hsetlik/DirtyMirrorV2/DirtyMirrorV2.kicad_pcb

## KiCad design DirtyMirrorV2.kicad_pcb (2026-08-28)

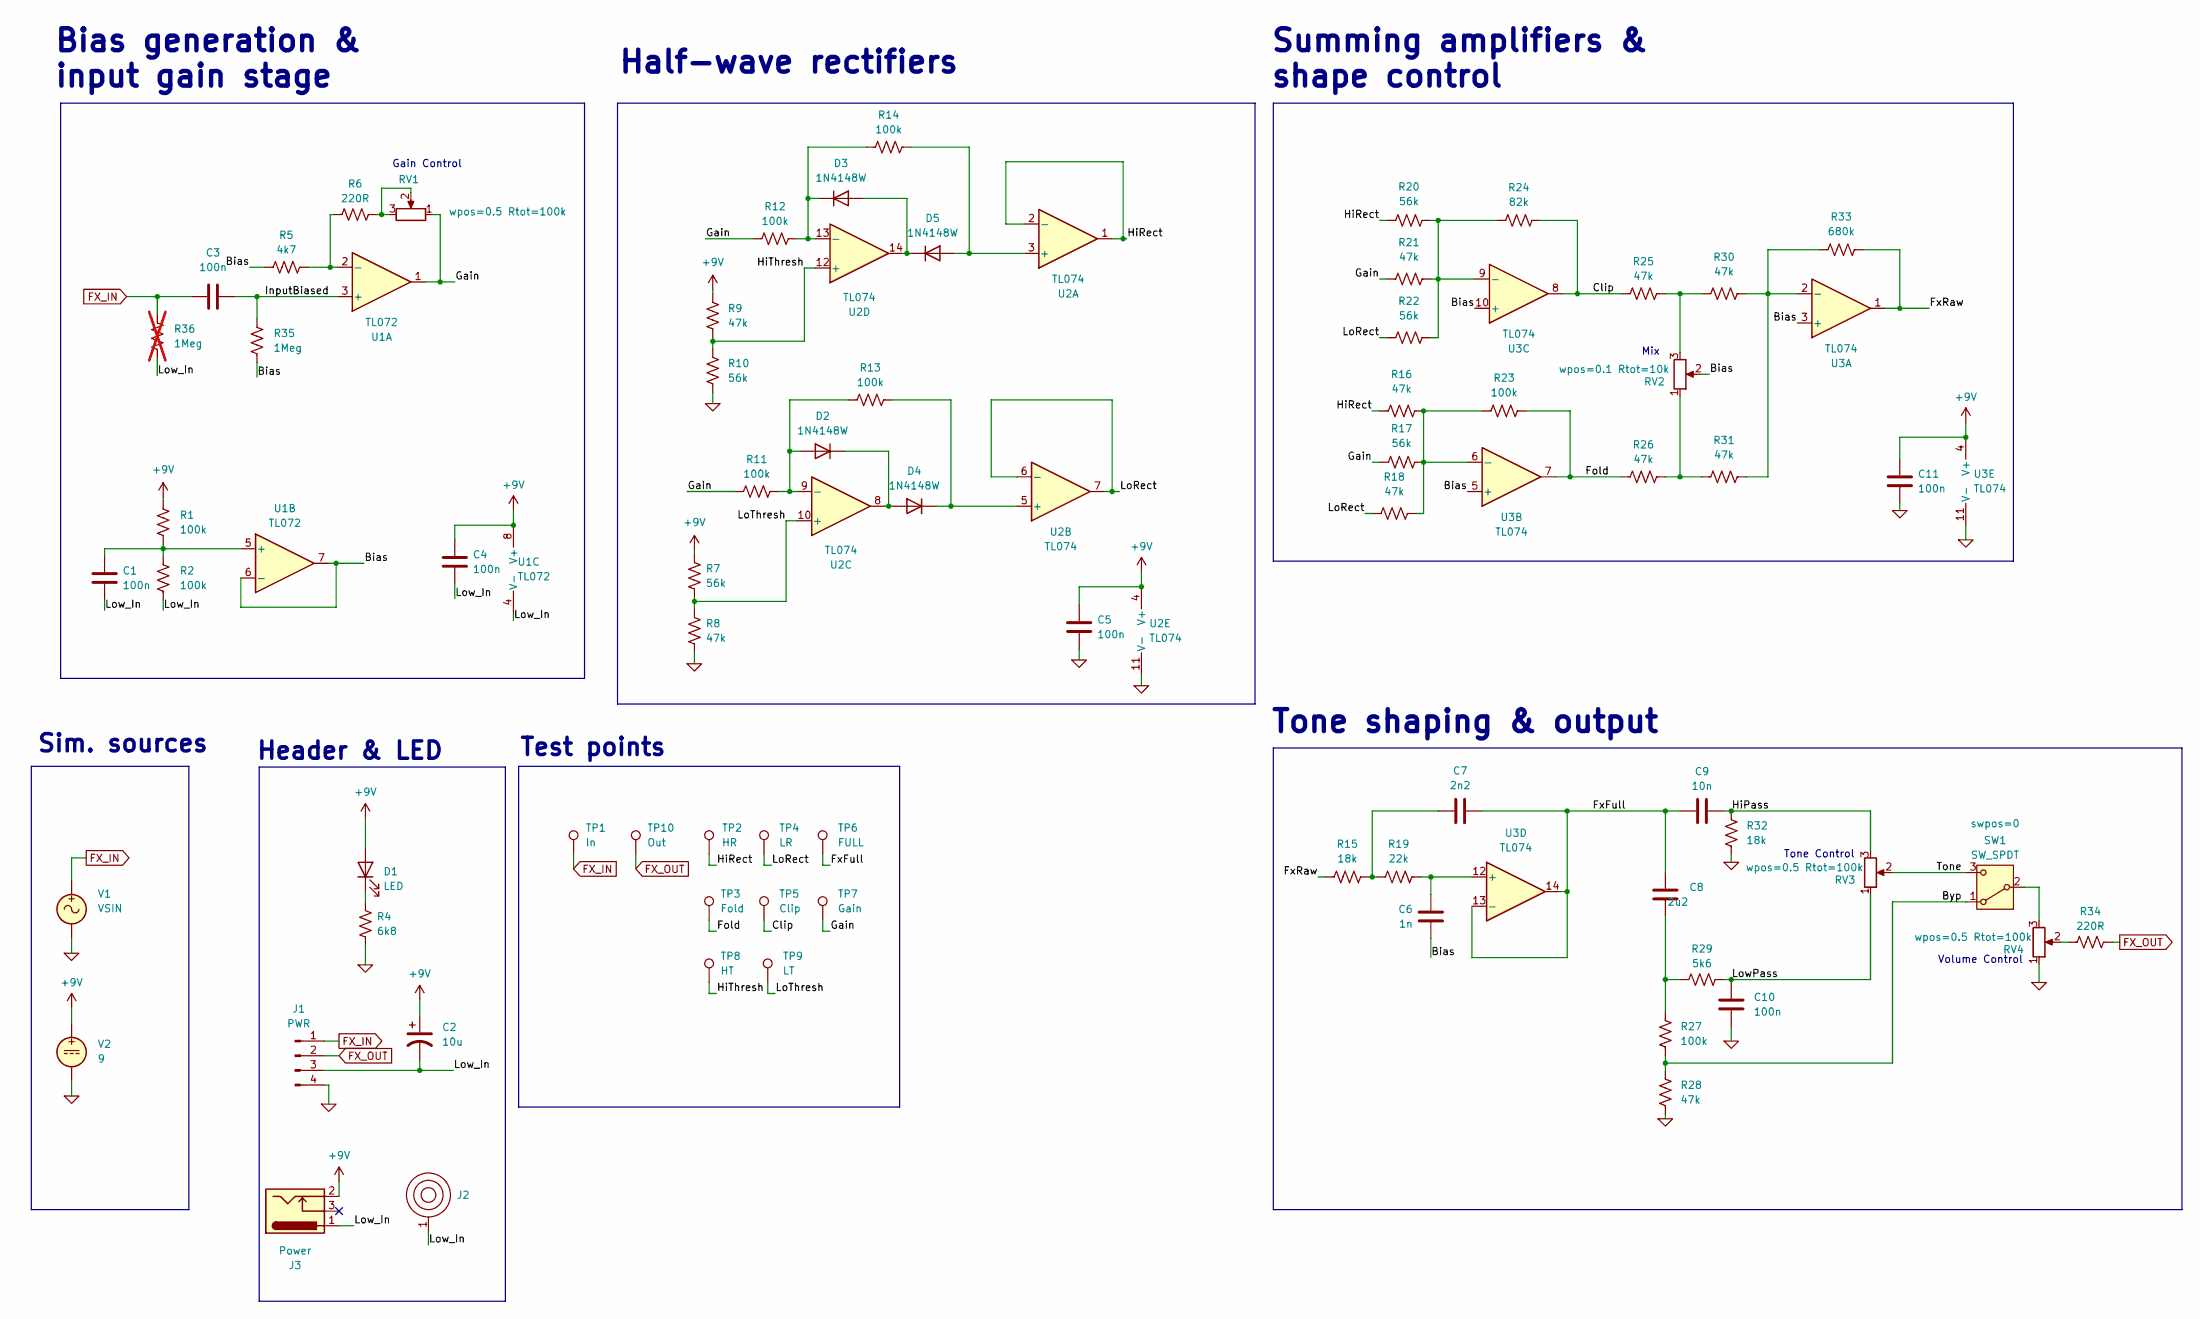
[picture p1: schematic DirtyMirrorV2.kicad_sch]

Parts:
C1, C3, C4, C5, C10, C11: 100n; C_0805_2012Metric
C2: 10u; CP_Radial_D5.0mm_P2.50mm
C6: 1n; C_0805_2012Metric
C7: 2n2; C_0805_2012Metric
C8: 2u2; C_0805_2012Metric
C9: 10n; C_0805_2012Metric
D1: LED; LED_D3.0mm
D2, D3, D4, D5: 1N4148W; D_SOD-123
J1: PWR; PinHeader_1x04_P2.54mm_Vertical
J2: BatteryContact_Keystone_243
J3: Power; BarrelJack_Horizontal
R1, R2, R11, R12, R13, R14, R23, R27: 100k; R_0805_2012Metric
R4: 6k8; R_0805_2012Metric
R5: 4k7; R_0805_2012Metric
R6, R34: 220R; R_0805_2012Metric
R7, R10, R17, R20, R22: 56k; R_0805_2012Metric
R8, R9, R16, R18, R21, R25, R26, R28, R30, R31: 47k; R_0805_2012Metric
R15, R32: 18k; R_0805_2012Metric
R19: 22k; R_0805_2012Metric
R24: 82k; R_0805_2012Metric
R29: 5k6; R_0805_2012Metric
R33: 680k; R_0805_2012Metric
R35: 1Meg; R_0805_2012Metric
R36: 1Meg; R_0805_2012Metric; not fitted
RV1, RV2, RV3, RV4: R_Potentiometer; Potentiometer_Alpha_RV16AF_42_Single_Long
SW1: SW_SPDT; SW_SPDT_Dailywell_Mini_1M
TP1: In; TestPoint_THTPad_D2.0mm_Drill1.0mm_VAL
TP2: HR; TestPoint_THTPad_D2.0mm_Drill1.0mm_VAL
TP3: Fold; TestPoint_THTPad_D2.0mm_Drill1.0mm_VAL
TP4: LR; TestPoint_THTPad_D2.0mm_Drill1.0mm_VAL
TP5: Clip; TestPoint_THTPad_D2.0mm_Drill1.0mm_VAL
TP6: FULL; TestPoint_THTPad_D2.0mm_Drill1.0mm_VAL
TP7: Gain; TestPoint_THTPad_D2.0mm_Drill1.0mm_VAL
TP8: HT; TestPoint_THTPad_D2.0mm_Drill1.0mm_VAL
TP9: LT; TestPoint_THTPad_D2.0mm_Drill1.0mm_VAL
TP10: Out; TestPoint_THTPad_D2.0mm_Drill1.0mm_VAL
U1: TL072; SOIC-8_3.9x4.9mm_P1.27mm
U2, U3: TL074; SOIC-14_3.9x8.7mm_P1.27mm
V1: VSIN
V2: 9

Connections:
0: C5.2, C10.2, C11.2, J1.4, R4.2, R8.2, R10.2, R28.2, R32.2, RV4.1, U2.11 (V-), U3.11 (V-), V1.2, V2.2
+9V: C2.1, C4.1, C5.1, C11.1, D1.2 (A), J3.2, R1.1, R7.1, R9.1, U1.8 (V+), U2.4 (V+), U3.4 (V+), V2.1
/Bias: C6.2, R5.1, R35.2, RV2.2, U1.6 (-), U1.7, U3.3 (+), U3.5 (+), U3.10 (+)
/Byp: R27.2, R28.1, SW1.1 (A)
/Clip: R24.2, R25.1, TP5.1 (1_1), U3.8
/Fold: R23.2, R26.1, TP3.1 (1_1), U3.7
/FxFull: C7.2, C8.1, C9.1, TP6.1 (1_1), U3.13 (-), U3.14
/FxRaw: R15.1, R33.2, U3.1
/Gain: R11.1, R12.1, R17.1, R21.1, RV1.1, TP7.1 (1_1), U1.1
/HiPass: C9.2, R32.1, RV3.3
/HiRect: R16.1, R20.1, TP2.1 (1_1), U2.1, U2.2 (-)
/HiThresh: R9.2, R10.1, TP8.1 (1_1), U2.12 (+)
/InputBiased: C3.2, R35.1, U1.3 (+)
/LoRect: R18.1, R22.1, TP4.1 (1_1), U2.6 (-), U2.7
/LoThresh: R7.2, R8.1, TP9.1 (1_1), U2.10 (+)
/LowPass: C10.1, R29.2, RV3.1
/Low_In: C1.2, C2.2, C4.2, J1.3, J2.1, J3.1, R2.2, R36.2, U1.4 (V-)
/Tone: RV3.2, SW1.3 (C)
FX_IN: C3.1, J1.1, R36.1, TP1.1 (1_1), V1.1
FX_OUT: J1.2, R34.2, TP10.1 (1_1)
unnamed: C7.1, R15.2, R19.1
unnamed: C8.2, R27.1, R29.1
unnamed: D1.1 (K), R4.1
unnamed: D2.2 (A), R11.2, R13.1, U2.9 (-)
unnamed: D2.1 (K), D4.2 (A), U2.8
unnamed: D3.2 (A), D5.1 (K), U2.14
unnamed: D3.1 (K), R12.2, R14.1, U2.13 (-)
unnamed: D4.1 (K), R13.2, U2.5 (+)
unnamed: D5.2 (A), R14.2, U2.3 (+)
unnamed: R6.2, RV1.2, RV1.3
unnamed: R25.2, R30.1, RV2.3
unnamed: R26.2, R31.1, RV2.1
unnamed: R34.1, RV4.2
unnamed: RV4.3, SW1.2 (B)
unnamed: R5.2, R6.1, U1.2 (-)
unnamed: C1.1, R1.2, R2.1, U1.5 (+)
unnamed: R30.2, R31.2, R33.1, U3.2 (-)
unnamed: R16.2, R17.2, R18.2, R23.1, U3.6 (-)
unnamed: R20.2, R21.2, R22.2, R24.1, U3.9 (-)
unnamed: C6.1, R19.2, U3.12 (+)

Notes on the sheet:
Test points
Gain Control
Sim. sources
Header & LED
Tone Control
Summing amplifiers & shape control
Mix
Bias generation & input gain stage
Volume Control
Half-wave rectifiers
Tone shaping & output

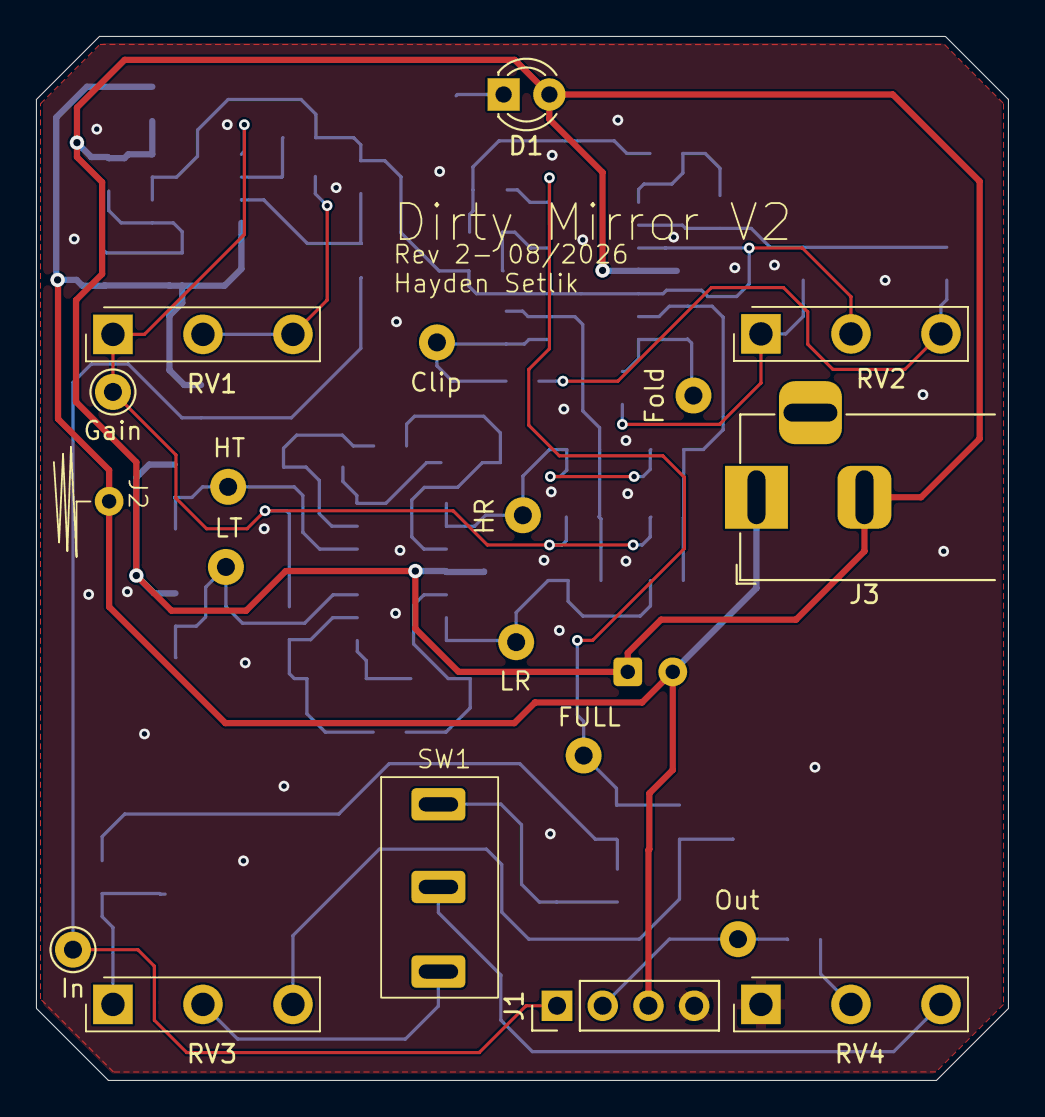
[picture p2: board DirtyMirrorV2.kicad_pcb from above]

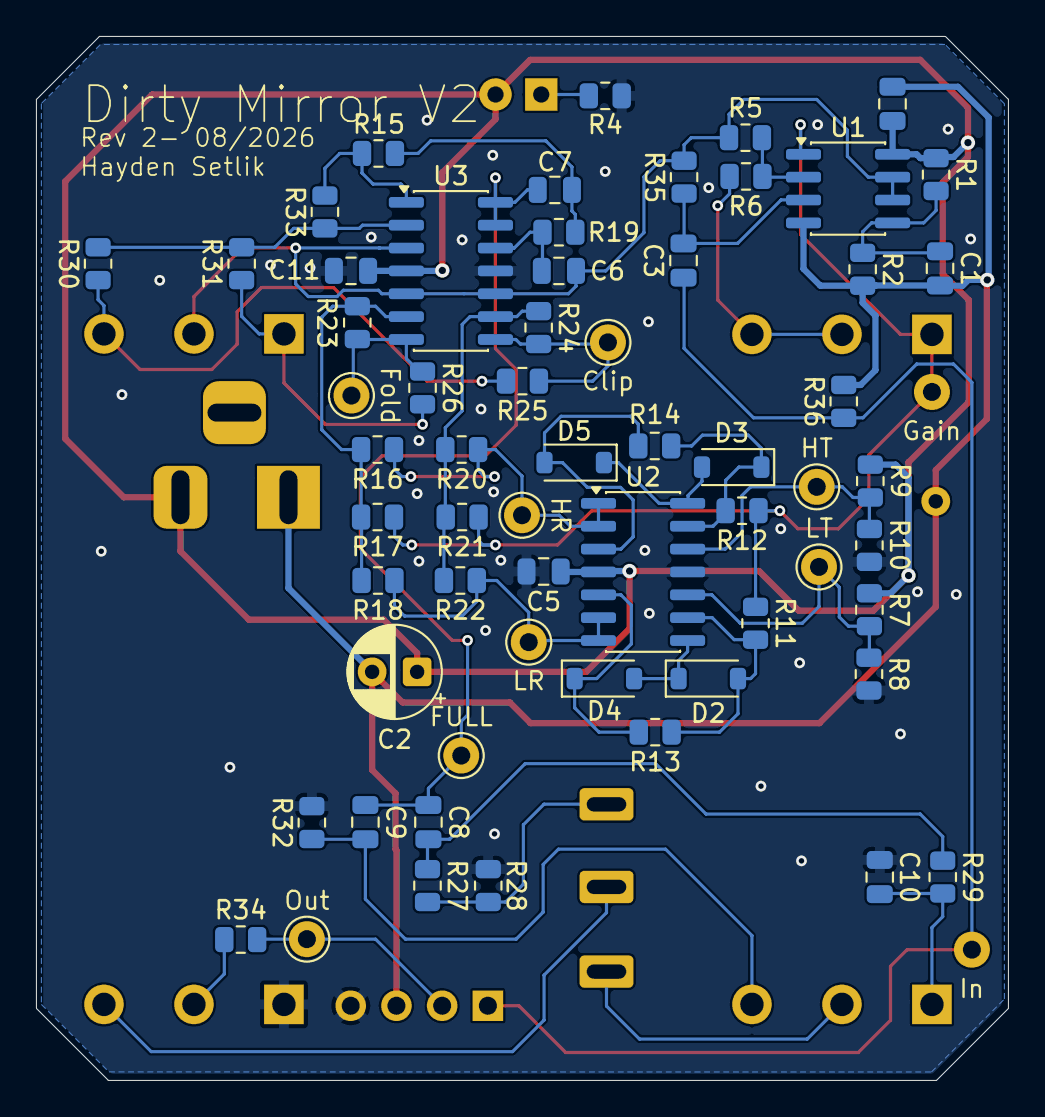
[picture p3: board DirtyMirrorV2.kicad_pcb from below]

Board: 2 copper layers, 54.0 x 58.0 mm, 72 parts (61 on the bottom side), 40 nets.
