hsetlik/DirtyMirrorV2/(commit log)

2026-01-28 simulation working, schem labeled
    [DirtyMirrorV2.kicad_sch]
2026-01-28 footprints assigned
    [DirtyMirrorV2.kicad_sch]
2026-01-29 board routed, DRC passing
    [DirtyMirrorV2.kicad_pcb, DirtyMirrorV2.kicad_sch]
2026-01-29 switched to routed power
    [DirtyMirrorV2.kicad_pcb]
2026-01-30 elbow room
    [DirtyMirrorV2.kicad_pcb]
2026-01-30 top jacks, new routing
    [DirtyMirrorV2.kicad_pcb]
2026-02-14 rev1 gerbers ready
    [DirtyMirrorV2.kicad_pcb]
2026-02-14 sike minor fix. DRC passing
    [DirtyMirrorV2.kicad_pcb]
2026-02-28 value tweaks, added BOM
    [DirtyMirrorV2.kicad_pcb, DirtyMirrorV2.kicad_sch]
2026-03-01 minor tweaks after sound testing
    [DirtyMirrorV2.kicad_sch]
2026-06-06 resistor values tweaked to taste
    [DirtyMirrorV2.kicad_pcb, DirtyMirrorV2.kicad_sch]
2026-06-07 higher output gain
    [DirtyMirrorV2.kicad_sch]
2026-06-09 changed tone ctrl high pass
    [DirtyMirrorV2.kicad_sch]
2026-06-09 added tone stack simulation
    [ToneStackSim.kicad_pcb, ToneStackSim.kicad_sch]
2026-06-11 switched tone bypass voltage divider
    [DirtyMirrorV2.kicad_sch]
2026-06-11 de-hissing butterworth changes
    [DirtyMirrorV2.kicad_sch]
2026-07-03 dehiss changes
    [DeHissFilterSim.kicad_pcb, DeHissFilterSim.kicad_sch, DirtyMirrorV2.kicad_pcb, DirtyMirrorV2.kicad_sch]
2026-07-07 switched hi-pass back
    [DirtyMirrorV2.kicad_sch, ToneStackSim.kicad_sch]
2026-07-31 component layout
    [DirtyMirrorV2.kicad_pcb, DirtyMirrorV2.kicad_sch]
2026-07-31 prelim routed, DRC passing
    [DirtyMirrorV2.kicad_pcb]
2026-08-07 moved bulk capacitor, silkscreen
    [DirtyMirrorV2.kicad_pcb, DirtyMirrorV2.kicad_sch]
2026-08-09 switched u1 circuitry to always on
    [DirtyMirrorV2.kicad_sch]
2026-08-09 new power scheme routed
    [DirtyMirrorV2.kicad_pcb]
2026-08-13 moved gain control to feedback loop
    [DirtyMirrorV2.kicad_pcb, DirtyMirrorV2.kicad_sch]
2026-08-14 grounding tweaks and corner bevels
    [DirtyMirrorV2.kicad_pcb, DirtyMirrorV2.kicad_sch]
2026-08-15 full pedal simulation
    [FullPedalSim.kicad_pcb, FullPedalSim.kicad_sch]
2026-08-21 rev2 sent to fab
    [DirtyMirrorV2.kicad_pcb, DirtyMirrorV2.kicad_sch]
2026-08-28 new BOM, lower gain on shape control amp
    [DirtyMirrorV2.kicad_pcb]
